wuyoutech/gugubot_mod_toolboard/image.png

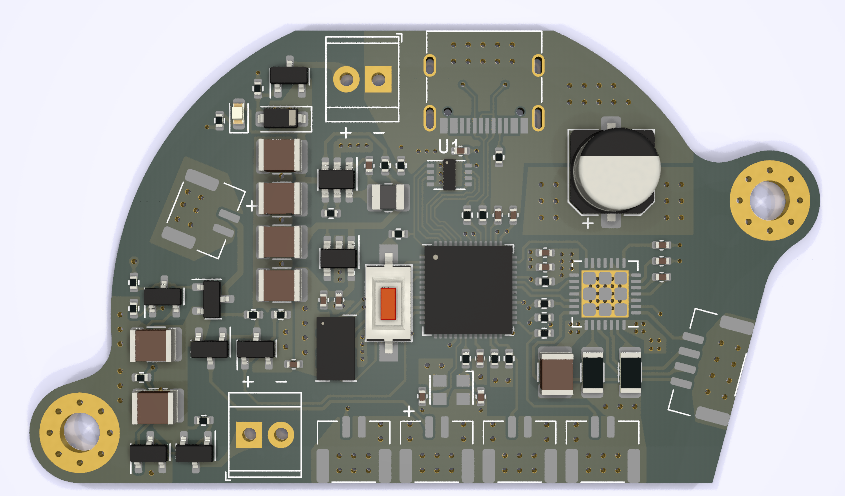
image.png
