wuyoutech/gugubot_mod_toolboard/gugubot_hotend.kicad_pcb

## KiCad design gugubot_hotend.kicad_pcb (2023-09-30)

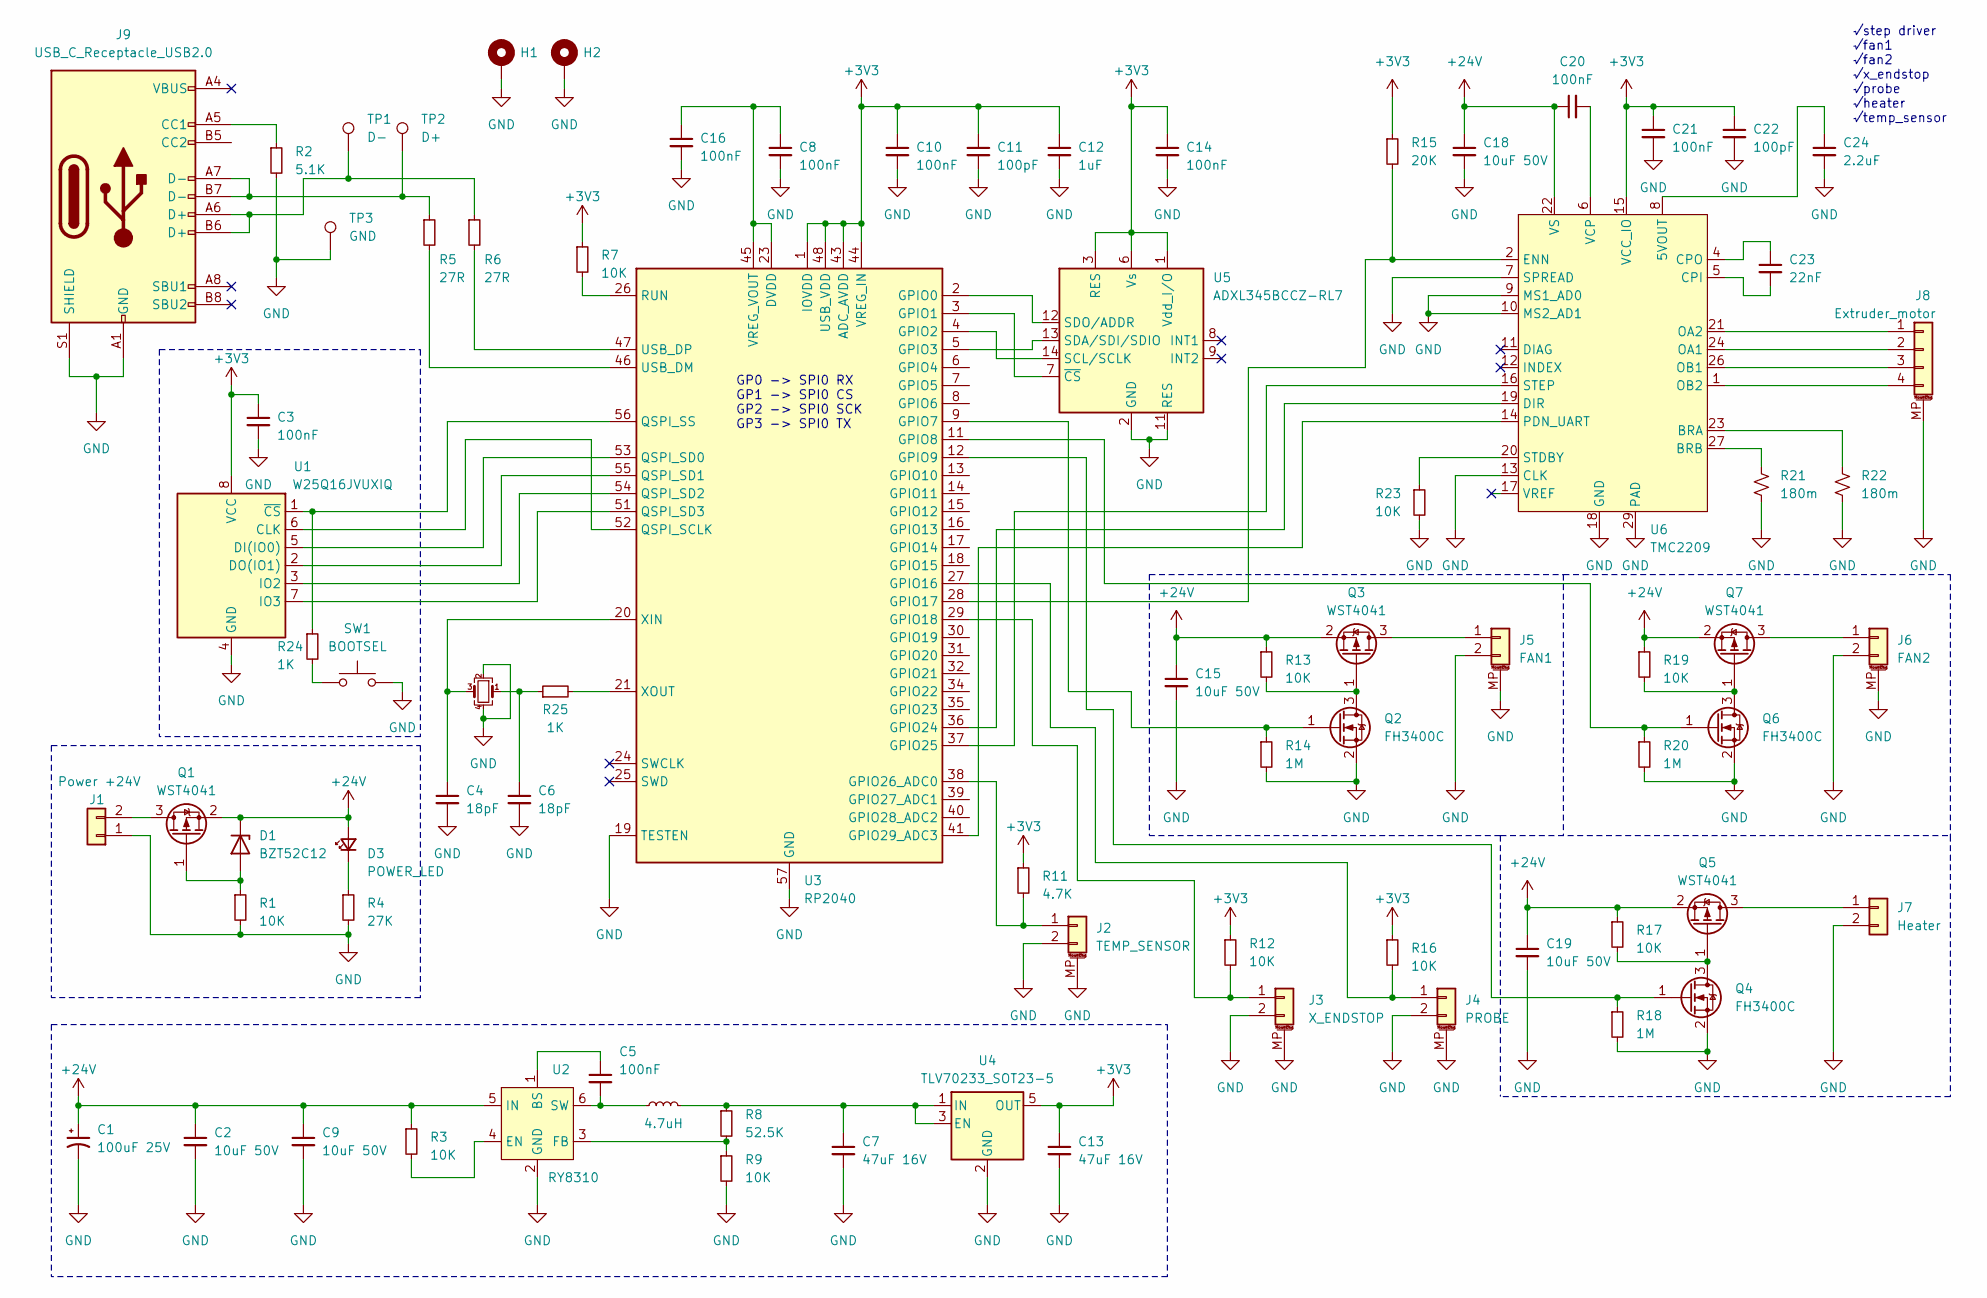
[picture p2: schematic gugubot_hotend.kicad_sch]

Parts:
C1: 100uF 25V; CP_Elec_6.3x5.8
C2, C9, C15, C18, C19: 10uF 50V; C_1210_3225Metric
C3, C5, C8, C10, C14, C16, C20, C21: 100nF; C_0402_1005Metric
C4, C6: 18pF; C_0402_1005Metric
C7, C13: 47uF 16V; C_1210_3225Metric
C11, C22: 100pF; C_0402_1005Metric
C12: 1uF; C_0402_1005Metric
C23: 22nF; C_0402_1005Metric
C24: 2.2uF; C_0402_1005Metric
D1: BZT52C12; D_SOD-123
D3: POWER_LED; LED_0603_1608Metric
H1, H2: MountingHole_Pad; MountingHole_3.2mm_M3_Pad_Via
J1: Power +24V; TerminalBlock_TE_282834-2_1x02_P2.54mm_Horizontal
J2: TEMP_SENSOR; GH_1.25_1x02_Horizontal
J3: X_ENDSTOP; GH_1.25_1x02_Horizontal
J4: PROBE; GH_1.25_1x02_Horizontal
J5: FAN1; GH_1.25_1x02_Horizontal
J6: FAN2; GH_1.25_1x02_Horizontal
J7: Heater; TerminalBlock_TE_282834-2_1x02_P2.54mm_Horizontal
J8: Extruder_motor; GH_1.25_1x04_Veritical
J9: USB_C_Receptacle_USB2.0; USB_C_Receptacle_G-Switch_GT-USB-7010ASV
L1: 4.7uH; L_1008_2520Metric
Q1, Q3, Q5, Q7: WST4041; SOT-23
Q2, Q4, Q6: FH3400C; SOT-23
R1, R3, R7, R9, R12, R13, R16, R17, R19, R23: 10K; R_0402_1005Metric
R2: 5.1K; R_0402_1005Metric
R4: 27K; R_0402_1005Metric
R5, R6: 27R; R_0402_1005Metric
R8: 52.5K; R_0402_1005Metric
R11: 4.7K; R_0402_1005Metric
R14, R18, R20: 1M; R_0402_1005Metric
R15: 20K; R_0402_1005Metric
R21, R22: 180m; R_1206_3216Metric
R24, R25: 1K; R_0402_1005Metric
SW1: BOOTSEL; SW_SPST_CK_RS282G05A3
TP1: D-; TestPoint_Pad_1.5x1.5mm
TP2: D+; TestPoint_Pad_1.5x1.5mm
TP3: GND; TestPoint_Pad_1.5x1.5mm
U1: W25Q16JVUXIQ; USON-8_3.0x2.0mm_P0.5mm
U2: RY8310; SOT-23-6
U3: RP2040; QFN-56-1EP_7x7mm_P0.4mm_EP3.2x3.2mm
U4: TLV70233_SOT23-5; SOT-23-5
U5: ADXL345BCCZ-RL7; LGA-14_3x5mm_P0.8mm_LayoutBorder1x6y
U6: TMC2209; QFN-28-1EP_5x5mm_P0.5mm_EP3.75x3.75mm
Y1: 12MHz; Oscillator_SMD_Kyocera_KC2520Z-4Pin_2.5x2.0mm

Connections:
+3V3: C3.1, C10.1, C11.1, C12.1, C13.1, C14.1, C21.1, C22.1, R7.1, R11.1, R12.1, R15.1, R16.1, U1.8 (VCC), U3.1 (IOVDD), U3.10 (IOVDD), U3.22 (IOVDD), U3.33 (IOVDD), U3.42 (IOVDD), U3.43 (ADC_AVDD), U3.44 (VREG_IN), U3.48 (USB_VDD), U3.49 (IOVDD), U4.5 (OUT), U5.1 (Vdd_I/O), U5.3 (RES), U5.6 (Vs), U6.15 (VCC_IO)
+24V: C1.1, C2.1, C9.1, C15.1, C18.1, C19.1, C20.1, D1.1 (K), D3.2 (A), Q1.2 (S), Q3.2 (S), Q5.2 (S), Q7.2 (S), R3.1, R13.1, R17.1, R19.1, U2.5 (IN), U6.22 (VS), U6.28 (VS)
GND: C1.2, C2.2, C3.2, C4.2, C6.2, C7.2, C8.2, C9.2, C10.2, C11.2, C12.2, C13.2, C14.2, C15.2, C16.2, C18.2, C19.2, C21.2, C22.2, C24.2, H1.1, H2.1, J1.1, J2.2, J2.MP (MountPin), J3.2, J3.MP (MountPin), J4.2, J4.MP (MountPin), J5.2, J5.MP (MountPin), J6.2, J6.MP (MountPin), J7.2, J8.MP (MountPin), J9.A1 (GND), J9.A12 (GND), J9.B1 (GND), J9.B12 (GND), J9.S1 (SHIELD), Q2.2 (S), Q4.2 (S), Q6.2 (S), R1.2, R2.2, R4.2, R9.2, R14.2, R18.2, R20.2, R21.2, R22.2, R23.2, SW1.1, TP3.1, U1.4 (GND), U1.9, U2.2 (GND), U3.19 (TESTEN), U3.57 (GND), U4.2 (GND), U5.2 (GND), U5.4 (GND), U5.5 (GND), U5.11 (RES), U6.3 (GND), U6.7 (SPREAD), U6.9 (MS1_AD0), U6.10 (MS2_AD1), U6.13 (CLK), U6.18 (GND), U6.29 (PAD), Y1.2, Y1.4
unnamed: C6.1, R25.1, Y1.1
unnamed: D1.2 (A), Q1.1 (G), R1.1
unnamed: D3.1 (K), R4.1
unnamed: J1.2, Q1.3 (D)
unnamed: J2.1, R11.2, U3.38 (GPIO26_ADC0)
unnamed: J3.1, R12.2, U3.29 (GPIO18)
unnamed: J4.1, R16.2, U3.27 (GPIO16)
unnamed: J5.1, Q3.3 (D)
unnamed: J6.1, Q7.3 (D)
unnamed: J7.1, Q5.3 (D)
unnamed: J8.1, U6.21 (OA2)
unnamed: J8.2, U6.24 (OA1)
unnamed: J8.3, U6.26 (OB1)
unnamed: J8.4, U6.1 (OB2)
unnamed: J9.A5 (CC1), R2.1
unnamed: J9.A6 (D+), J9.B6 (D+), R6.1, TP1.1
unnamed: J9.A7 (D-), J9.B7 (D-), R5.1, TP2.1
unnamed: Q2.3 (D), Q3.1 (G), R13.2
unnamed: Q2.1 (G), R14.1, U3.9 (GPIO7)
unnamed: Q4.3 (D), Q5.1 (G), R17.2
unnamed: Q4.1 (G), R18.1, U3.12 (GPIO9)
unnamed: Q6.3 (D), Q7.1 (G), R19.2
unnamed: Q6.1 (G), R20.1, U3.11 (GPIO8)
unnamed: R24.2, SW1.2
unnamed: U1.6 (CLK), U3.52 (QSPI_SCLK)
unnamed: U1.5 (DI(IO0)), U3.53 (QSPI_SD0)
unnamed: U1.2 (DO(IO1)), U3.55 (QSPI_SD1)
unnamed: U1.3 (IO2), U3.54 (QSPI_SD2)
unnamed: U1.7 (IO3), U3.51 (QSPI_SD3)
unnamed: R24.1, U1.1 (~CS), U3.56 (QSPI_SS)
unnamed: C5.1, U2.1 (BS)
unnamed: R3.2, U2.4 (EN)
unnamed: R8.2, R9.1, U2.3 (FB)
unnamed: C5.2, L1.1, U2.6 (SW)
unnamed: U3.2 (GPIO0), U5.12 (SDO/ADDR)
unnamed: U3.3 (GPIO1), U5.7 (~CS)
unnamed: U3.4 (GPIO2), U5.14 (SCL/SCLK)
unnamed: U3.5 (GPIO3), U5.13 (SDA/SDI/SDIO)
unnamed: R15.2, U3.28 (GPIO17), U6.2 (ENN)
unnamed: U3.36 (GPIO24), U6.19 (DIR)
unnamed: U3.37 (GPIO25), U6.16 (STEP)
unnamed: U3.41 (GPIO29_ADC3), U6.14 (PDN_UART)
unnamed: R7.2, U3.26 (RUN)
unnamed: R5.2, U3.46 (USB_DM)
unnamed: R6.2, U3.47 (USB_DP)
unnamed: C8.1, C16.1, U3.23 (DVDD), U3.45 (VREG_VOUT), U3.50 (DVDD)
unnamed: C4.1, U3.20 (XIN), Y1.3
unnamed: R25.2, U3.21 (XOUT)
unnamed: C7.1, L1.2, R8.1, U4.1 (IN), U4.3 (EN)
unnamed: C24.1, U6.8 (5VOUT)
unnamed: R22.1, U6.23 (BRA)
unnamed: R21.1, U6.27 (BRB)
unnamed: C23.2, U6.5 (CPI)
unnamed: C23.1, U6.4 (CPO)
unnamed: R23.1, U6.20 (STDBY)
unnamed: C20.2, U6.6 (VCP)

Notes on the sheet:
√step driver √fan1 √fan2 √x_endstop √probe √heater √temp_sensor
GP0 -> SPI0 RX GP1 -> SPI0 CS GP2 -> SPI0 SCK GP3 -> SPI0 TX

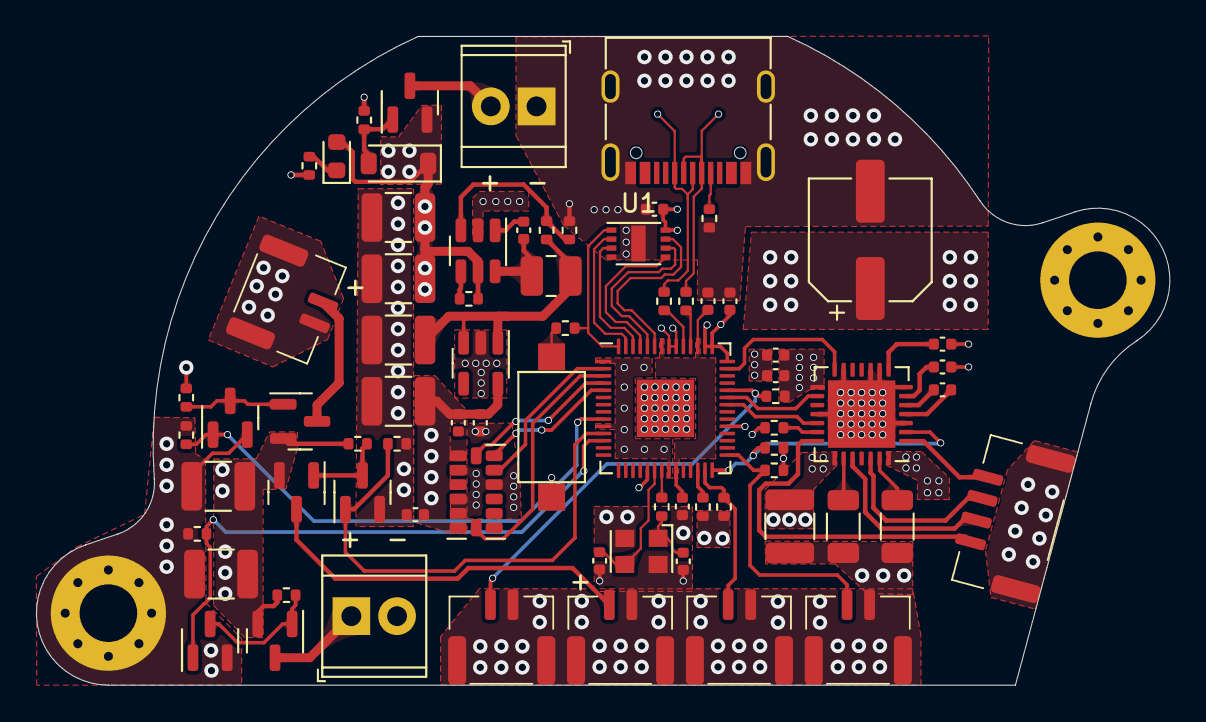
[picture p3: board gugubot_hotend.kicad_pcb from above]

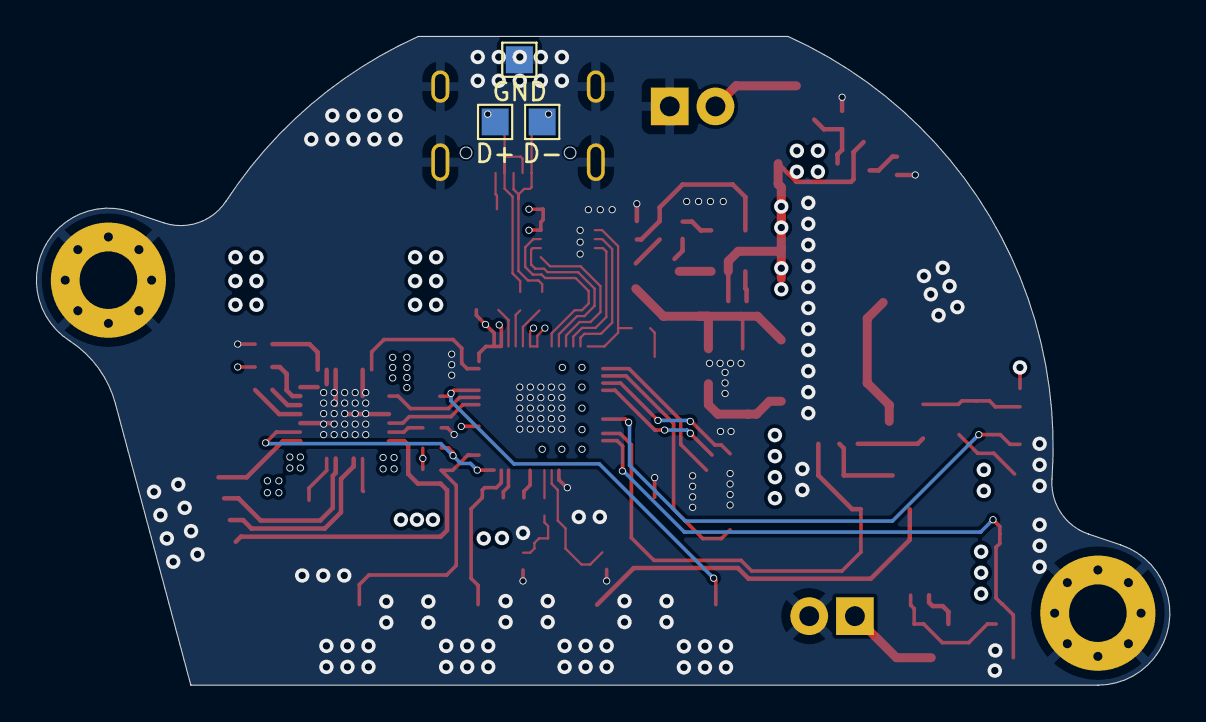
[picture p4: board gugubot_hotend.kicad_pcb from below]

Board: 4 copper layers, 63.0 x 36.0 mm, 79 parts (3 on the bottom side), 59 nets.
