wuyoutech/gugubot_mod_toolboard/(commit log)

2023-10-12 update bom
    [gugubot_hotend_bom.csv]
2023-11-04 fix bom number bug
    [gugubot_hotend_bom.csv]
